gurayozgur/Capstone-Project/drawings/lock_module/front.JPG

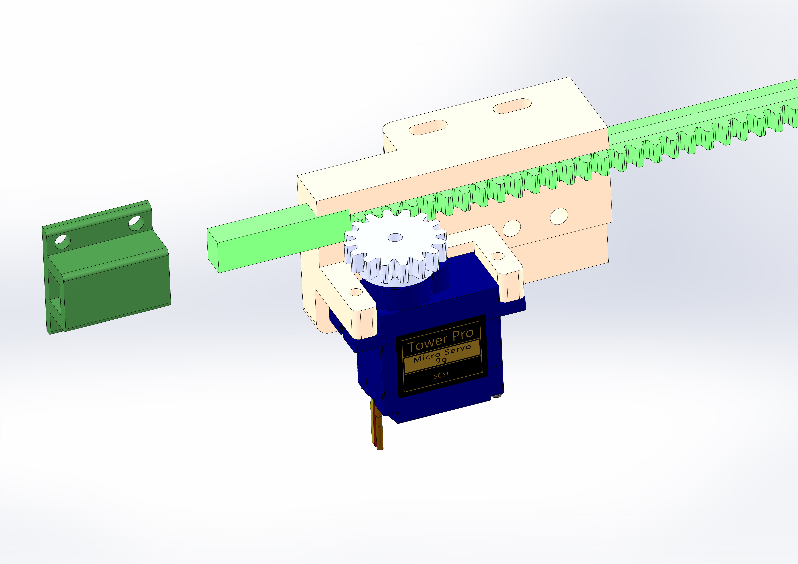
drawings/lock_module/front.JPG
