gurayozgur/Capstone-Project/drawings/surv_module/back.JPG

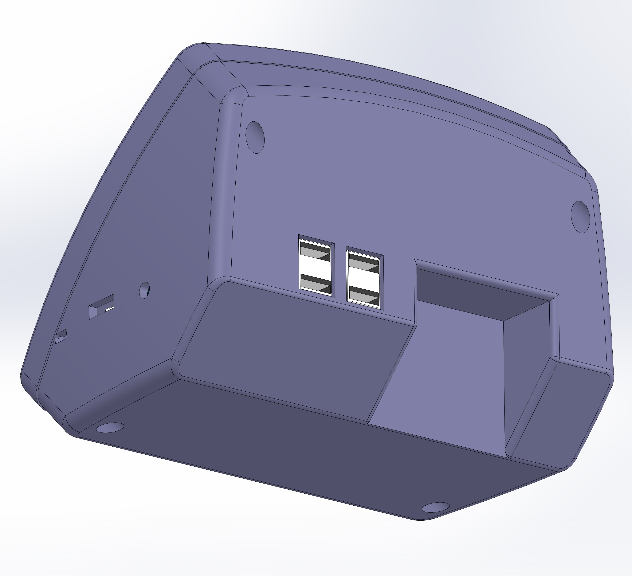
drawings/surv_module/back.JPG
