gurayozgur/Capstone-Project/drawings/surv_module/front.JPG

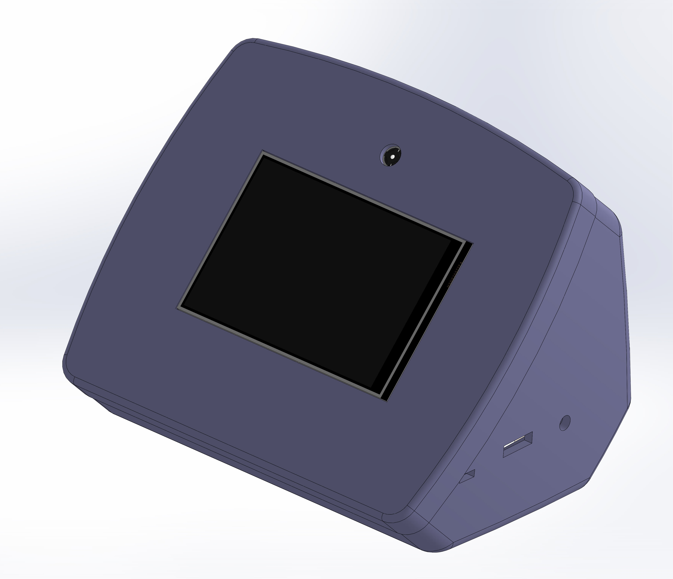
drawings/surv_module/front.JPG
