gurayozgur/Capstone-Project/drawings/surv_module/inside.JPG

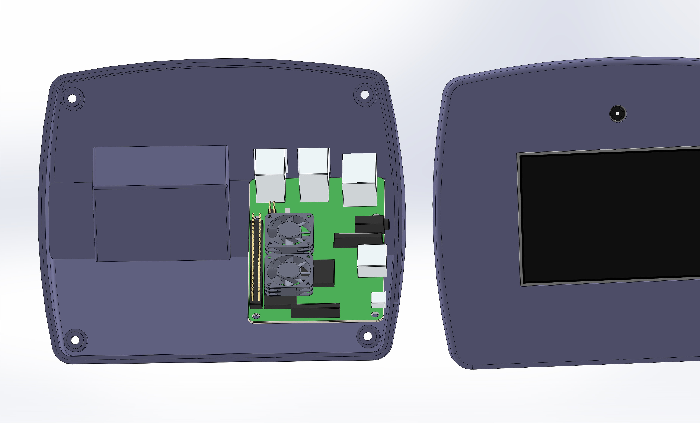
drawings/surv_module/inside.JPG
