gurayozgur/Capstone-Project/drawings/temp_sens_module/inside.JPG

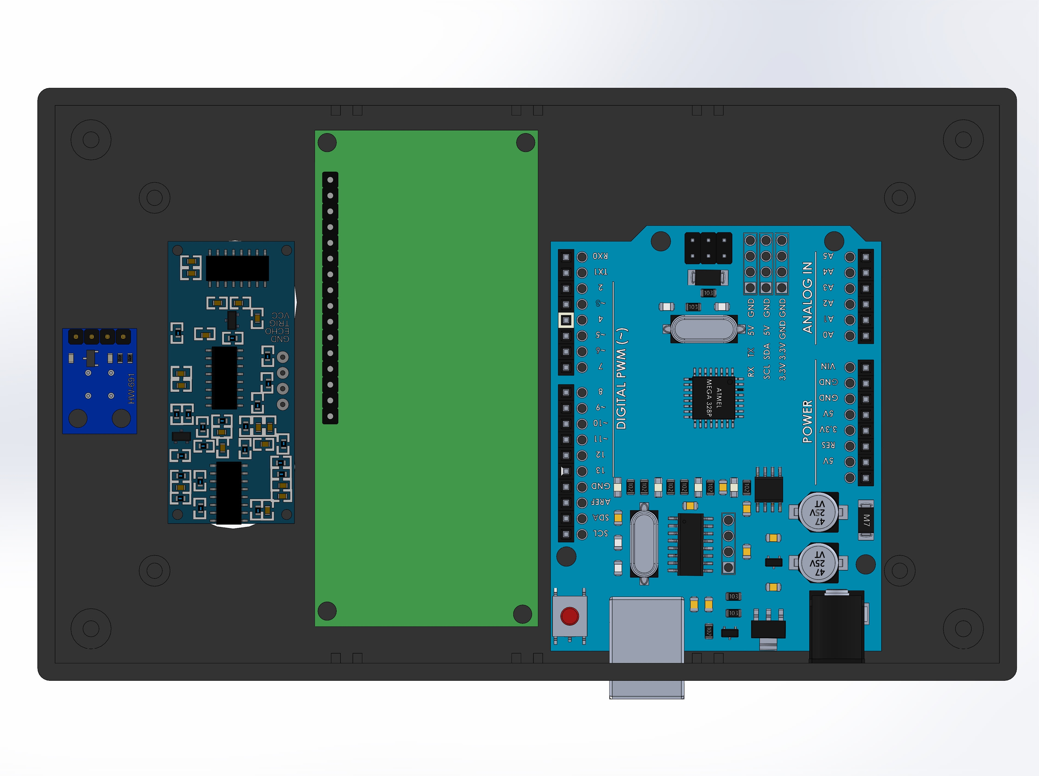
drawings/temp_sens_module/inside.JPG
