gurayozgur/Capstone-Project/drawings/temp_sens_module/outside.JPG

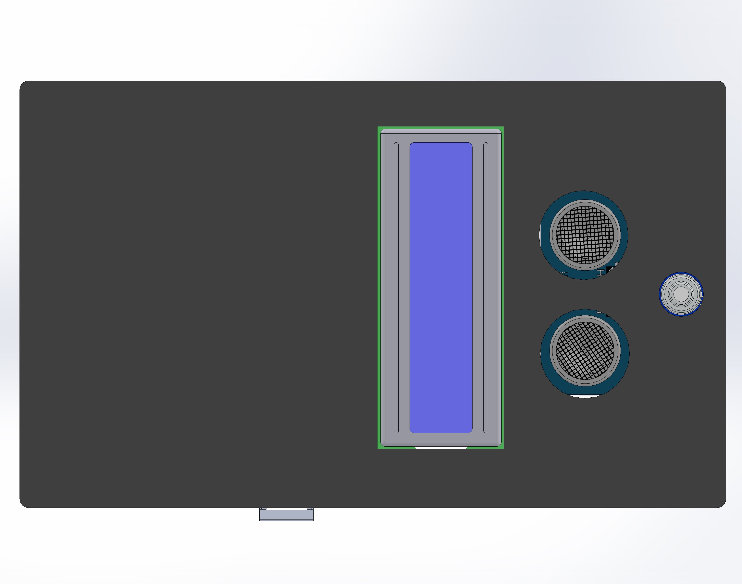
drawings/temp_sens_module/outside.JPG
