gurayozgur/Capstone-Project/(list of files, cad)

Other CAD files:
drawings/lock_module/lock.x_t
